trun/fpgaboy/input_controller.v

`default_nettype none
`timescale 1ns / 1ps

module input_controller(
  input  wire        clock,
  input  wire        reset,
  input  wire        int_ack,  
  output reg         int_req,
  input  wire [15:0] A,
  input  wire  [7:0] Di,
  output wire  [7:0] Do,
  input  wire        rd_n,
  input  wire        wr_n,
  input  wire        cs,
  output reg   [1:0] button_sel,
  input  wire  [3:0] button_data
);
  
  ////////////////////////////////////////////////
  // Joypad Registers
  // 
  // JOYP - Joypad (FF00)
  //   Bit 5: 0 <= select button keys (R/W)
  //   Bit 4: 0 <= select direction keys (R/W)
  //   Bit 3: 0 <= Down  or Start
  //   Bit 2: 0 <= Up    or Select
  //   Bit 1: 0 <= Left  or B
  //   Bit 0: 0 <= Right or A
  ////////////////////////////////////////////////

  always @(posedge clock)
  begin
    if (reset)
    begin
      int_req <= 0;
    end
    else
    begin      
      if (!wr_n)
      begin
        if (A == 16'hFF00)
        begin
          button_sel <= Di[5:4];
        end
      end
    end
  end

  assign Do = (cs) ? { 2'b11, button_sel[1:0], button_data[3:0] } : 8'hFF;

endmodule
