trun/fpgaboy/(commit log)

2012-04-28 add original vga controller and framebuffer modules
2012-04-29 add interrupt table rom
2012-04-29 fix top level clock for atlys board initialize boot and jump ROMs from file instead of using the IP CORE generator
2012-04-29 fix divider behavior with very high count values
    [divider.v]
2012-04-30 fix ambiguous naming of pins connecting the PPU <-> MMU and PPU <-> VRAM
    [video_controller.v]
2012-04-30 add switch based step clock for debugging
2012-04-30 add net entries for PMOD connectors on the VmodMIB expansion board in a more usable format
2012-04-30 remove some unused assignments and wires
2012-06-21 "working" hex display driver connected to CPU registers
2012-07-07 reenable interrupts after RETI command
2012-07-14 fix typo in video controller
    [video_controller.v]
2012-07-14 add joypad button presses to debug output
